samvangysegem/ch32-baseboard/ch32-baseboard-kicad/ch32-baseboard-kicad.kicad_pcb

## KiCad design ch32-baseboard-kicad/ch32-baseboard-kicad.kicad_pcb (2025-12-12)

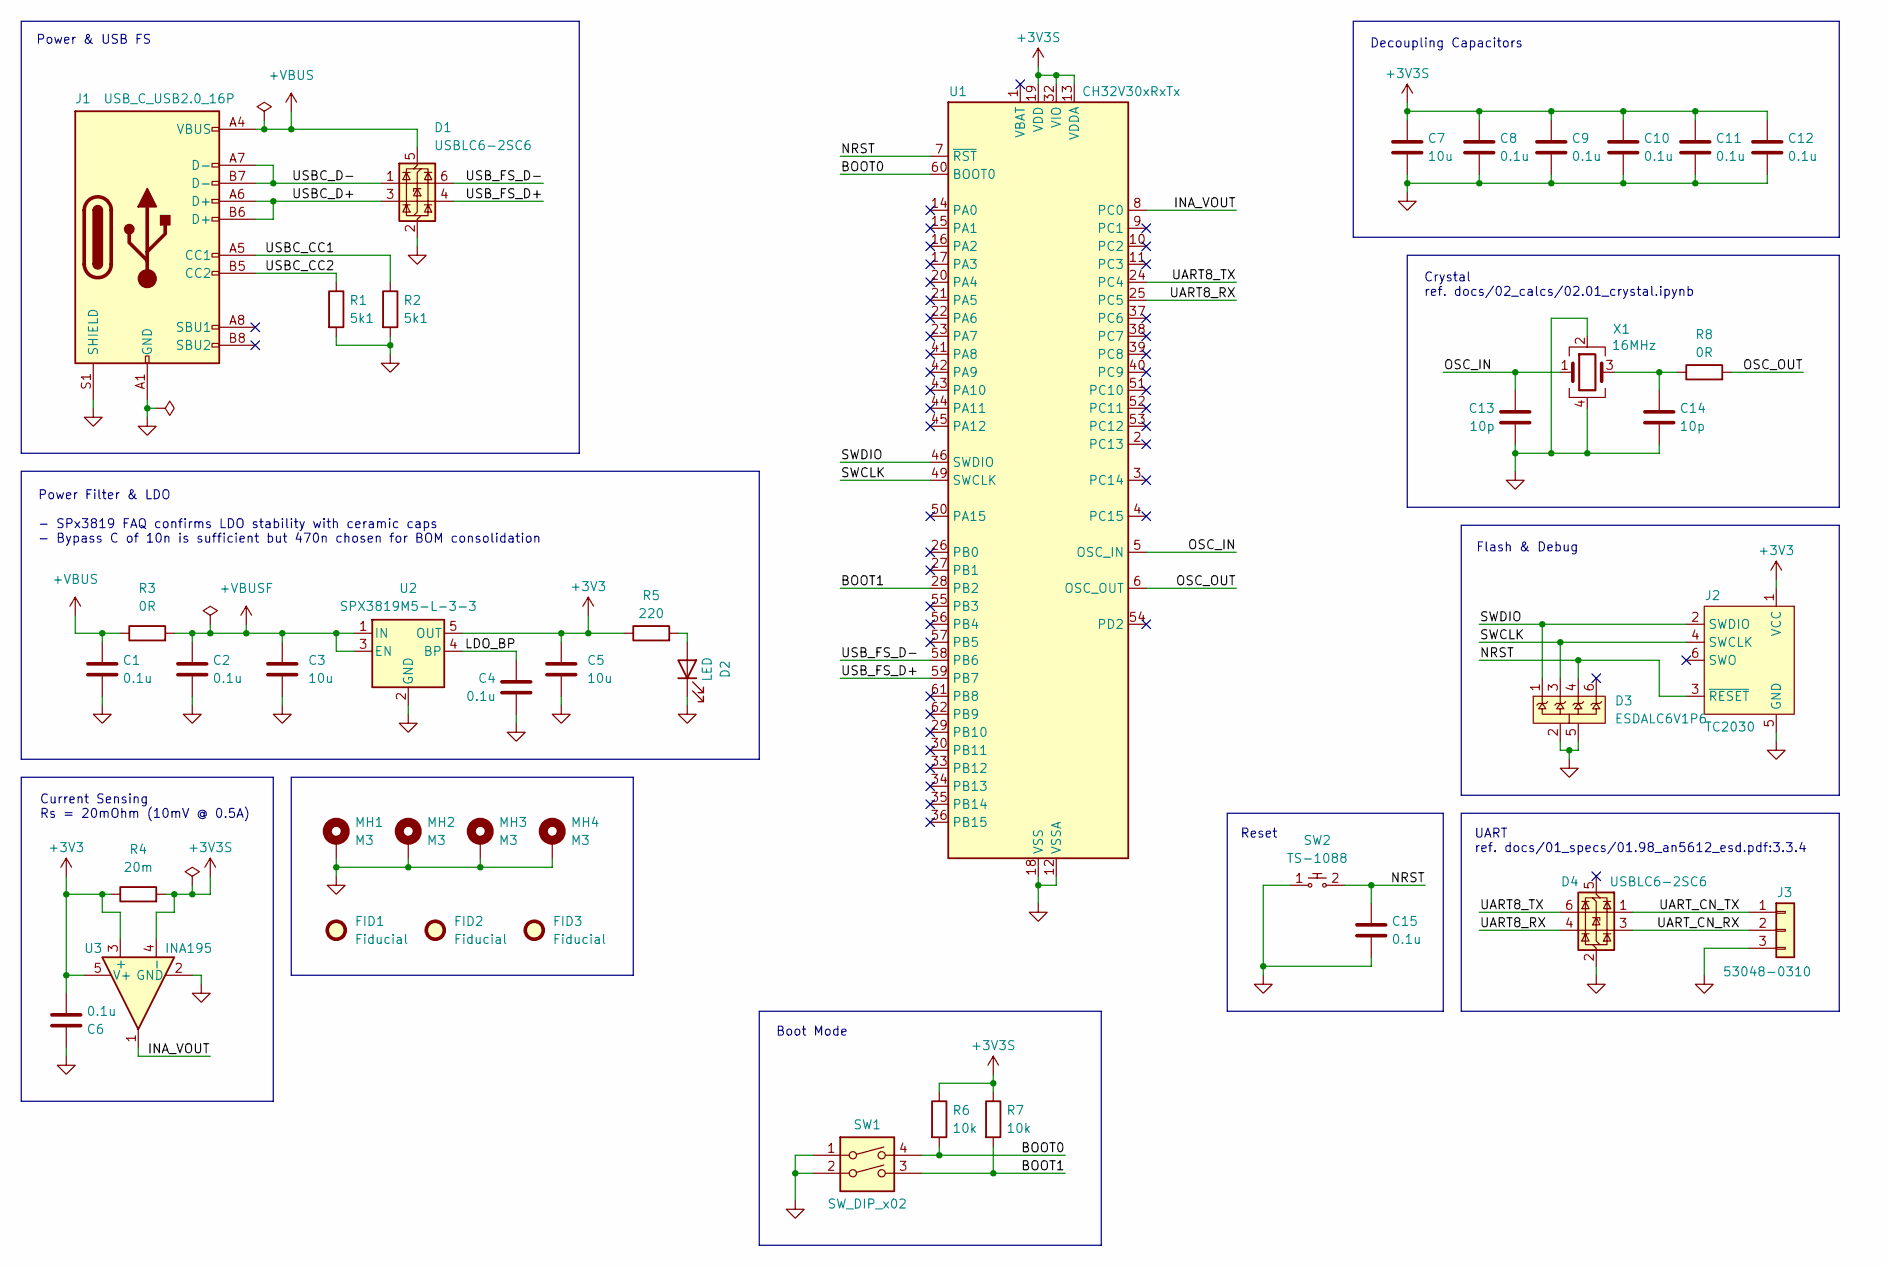
[picture p1: schematic ch32-baseboard-kicad.kicad_sch, CH32 Baseboard]

Parts:
C1, C2, C4, C6, C8, C9, C10, C11, C12, C15: 0.1u; C_0402_1005Metric; Manufacturer Part Number CL05B104KO5NNNC; JLCPCB Part Number C1525
C3, C5, C7: 10u; C_0805_2012Metric; Manufacturer Part Number CL21A106KAYNNNE; JLCPCB Part Number C15850
C13, C14: 10p; C_0402_1005Metric; Manufacturer Part Number CL05C100JB5NNNC; JLCPCB Part Number C32949
D1, D4: USBLC6-2SC6; SOT-23-6; Manufacturer Part Number USBLC6-2SC6; JLCPCB Part Number C7519
D2: LED; LED_0603_1608Metric; Manufacturer Part Number KT-0603W; JLCPCB Part Number C2290
D3: ESDALC6V1P6; SOT-666IP-STM; Manufacturer Part Number ESDALC6V1P6; JLCPCB Part Number C1976562
FID1, FID2, FID3: Fiducial; Fiducial_1mm_Mask2mm
J1: USB_C_USB2.0_16P; USB_C_Receptacle_GCT_USB4105-xx-A_16P_TopMnt_Horizontal; Manufacturer Part Number TYPE-C 16PIN 2MD(073); JLCPCB Part Number C2765186
J2: TC2030; Tag-Connect_TC2030-IDC-FP_2x03_P1.27mm_Vertical
J3: 53048-0310; Molex_PicoBlade_53048-0310_1x03_P1.25mm_Horizontal; Manufacturer Part Number 530480310; JLCPCB Part Number C505275
MH1, MH2, MH3, MH4: M3; MountingHole_3.2mm_M3_Pad_Via
R1, R2: 5k1; R_0402_1005Metric; Manufacturer Part Number 0402WGF5101TCE; JLCPCB Part Number C25905
R3: 0R; R_0805_2012Metric_Pad1.20x1.40mm_HandSolder; Manufacturer Part Number 0805W8F0000T5E; JLCPCB Part Number C17477
R4: 20m; R_1206_3216Metric; Manufacturer Part Number LR1206-21R020F4; JLCPCB Part Number C154638
R5: 220; R_0603_1608Metric; Manufacturer Part Number 0603WAF2200T5E; JLCPCB Part Number C22962
R6, R7: 10k; R_0603_1608Metric; Manufacturer Part Number 0603WAF1002T5E; JLCPCB Part Number C25804
R8: 0R; R_0402_1005Metric; Manufacturer Part Number 0402WGF0000TCE; JLCPCB Part Number C17168
SW1: SW_DIP_x02; SW_DIP_SPSTx02_Slide_6.7x6.64mm_W8.61mm_P2.54mm_LowProfile; Manufacturer Part Number SMXS-02K-TP; JLCPCB Part Number C5439761
SW2: TS-1088; SW_SPST_TS-1088-xR020; Manufacturer Part Number TS-1088-AR02016; JLCPCB Part Number C720477
U1: CH32V30xRxTx; LQFP-64_10x10mm_P0.5mm; Manufacturer Part Number CH32V305RBT6; JLCPCB Part Number C5187529
U2: SPX3819M5-L-3-3; SOT-23-5; Manufacturer Part Number SPX3819M5-L-3-3/TR; JLCPCB Part Number C9055
U3: INA195; SOT-23-5; Manufacturer Part Number INA195AIDBVT; JLCPCB Part Number C2653834
X1: 16MHz; Crystal_SMD_3225-4Pin_3.2x2.5mm; Manufacturer Part Number X322516MLB4SI; JLCPCB Part Number C13738

Connections:
+3V3: C5.1, C6.2, J2.1 (VCC), R4.1, R5.1, U2.5 (OUT), U3.3 (+), U3.5 (V+)
+3V3S: C7.1, C8.1, C9.1, C10.1, C11.1, C12.1, R4.2, R6.1, R7.1, U1.13 (VDDA), U1.19 (VDD), U1.32 (VIO), U1.48 (VDD), U1.64 (VIO), U3.4 (-)
+VBUS: C1.1, D1.5 (VBUS), J1.A4 (VBUS), J1.A9 (VBUS), J1.B4 (VBUS), J1.B9 (VBUS), R3.1
+VBUSF: C2.1, C3.1, R3.2, U2.1 (IN), U2.3 (EN)
/BOOT0: R6.2, SW1.4, U1.60 (BOOT0)
/BOOT1: R7.2, SW1.3, U1.28 (PB2)
/INA_VOUT: U1.8 (PC0), U3.1
/LDO_BP: C4.1, U2.4 (BP)
/NRST: C15.1, D3.4, J2.3 (~RESET), SW2.2, U1.7 (~RST)
/OSC_IN: C13.1, U1.5 (OSC_IN), X1.1
/OSC_OUT: R8.2, U1.6 (OSC_OUT)
/SWCLK: D3.3, J2.4 (SWCLK), U1.49 (SWCLK)
/SWDIO: D3.1, J2.2 (SWDIO), U1.46 (SWDIO)
/UART8_RX: D4.4 (I/O2), U1.25 (PC5)
/UART8_TX: D4.6 (I/O1), U1.24 (PC4)
/UART_CN_RX: D4.3 (I/O2), J3.2
/UART_CN_TX: D4.1 (I/O1), J3.1
/USBC_CC1: J1.A5 (CC1), R2.1
/USBC_CC2: J1.B5 (CC2), R1.1
/USBC_D+: D1.3 (I/O2), J1.A6 (D+), J1.B6 (D+)
/USBC_D-: D1.1 (I/O1), J1.A7 (D-), J1.B7 (D-)
/USB_FS_D+: D1.4 (I/O2), U1.59 (PB7)
/USB_FS_D-: D1.6 (I/O1), U1.58 (PB6)
GND: C1.2, C2.2, C3.2, C4.2, C5.2, C6.1, C7.2, C8.2, C9.2, C10.2, C11.2, C12.2, C13.2, C14.2, C15.2, D1.2 (GND), D2.1 (K), D3.2, D3.5, D4.2 (GND), J1.A1 (GND), J1.A12 (GND), J1.B1 (GND), J1.B12 (GND), J1.S1 (SHIELD), J2.5 (GND), J3.3, MH1.1, MH2.1, MH3.1, MH4.1, R1.2, R2.2, SW1.1, SW1.2, SW2.1, U1.12 (VSSA), U1.18 (VSS), U1.31 (VSS), U1.47 (VSS), U1.63 (VSS), U2.2 (GND), U3.2 (GND), X1.2, X1.4
unnamed: C14.1, R8.1, X1.3
unnamed: D2.2 (A), R5.2

Notes on the sheet:
UART ref. docs/01_specs/01.98_an5612_esd.pdf:3.3.4
Current Sensing Rs = 20mOhm (10mV @ 0.5A)
Reset
Crystal ref. docs/02_calcs/02.01_crystal.ipynb
Power & USB FS
Decoupling Capacitors
Boot Mode
Flash & Debug
Power Filter & LDO - SPx3819 FAQ confirms LDO stability with ceramic caps - Bypass C of 10n is sufficient but 470n chosen for BOM consolidation

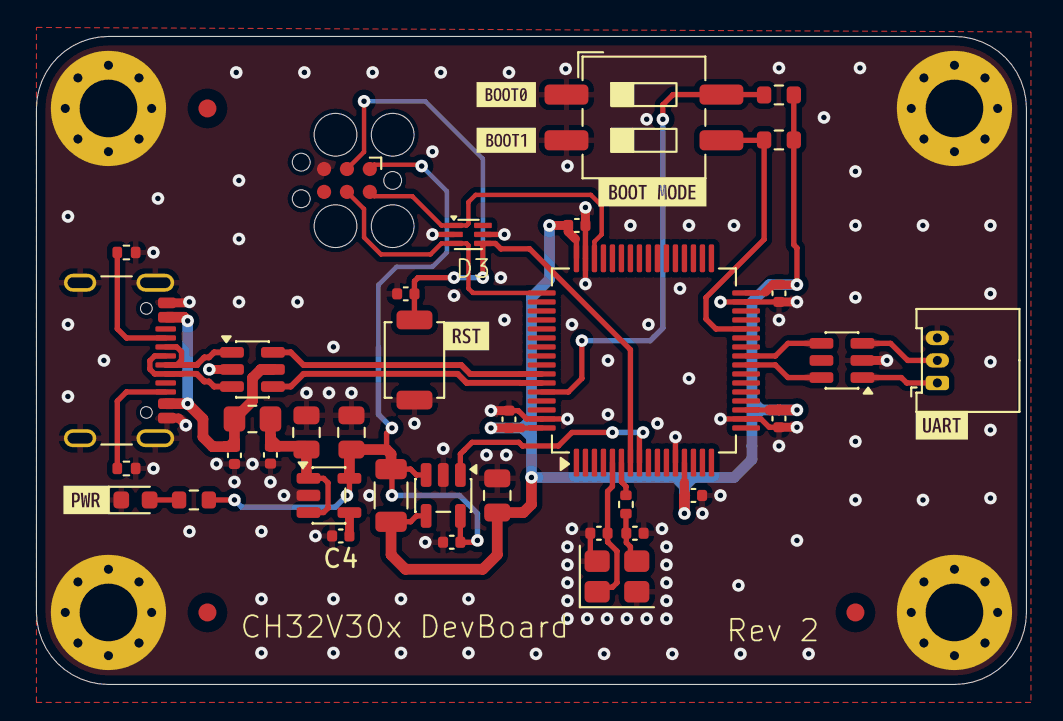
[picture p2: board ch32-baseboard-kicad.kicad_pcb from above]

Board: 4 copper layers, 55.0 x 36.0 mm, 49 parts (0 on the bottom side), 26 nets.

Other parts of the board:
kibuzzard-692C82B7: G***; kibuzzard-692C82B7
kibuzzard-692C82FA: G***; kibuzzard-692C82FA
kibuzzard-692C811E: G***; kibuzzard-692C811E
kibuzzard-692C8041: G***; kibuzzard-692C8041
kibuzzard-6935C0F9: G***; kibuzzard-6935C0F9
kibuzzard-6935C105: G***; kibuzzard-6935C105
