samvangysegem/ch32-baseboard/(commit log)

2025-12-07 feat: ch32 baseboard v1.0
    [ch32-baseboard-kicad.kicad_pcb, ch32-baseboard-kicad.kicad_sch]
2025-12-12 feat: silkscreen updates, manufacturing files
    [ch32-baseboard-kicad-B_Cu.gbr, ch32-baseboard-kicad-B_Mask.gbr, ch32-baseboard-kicad-Edge_Cuts.gbr, ch32-baseboard-kicad-F_Cu.gbr, ch32-baseboard-kicad-F_Mask.gbr, ch32-baseboard-kicad-F_Paste.gbr, ch32-baseboard-kicad-F_Silkscreen.gbr, ch32-baseboard-kicad-In1_Cu.gbr]
